Koumbaya/Kopesh/kopesh.bmp

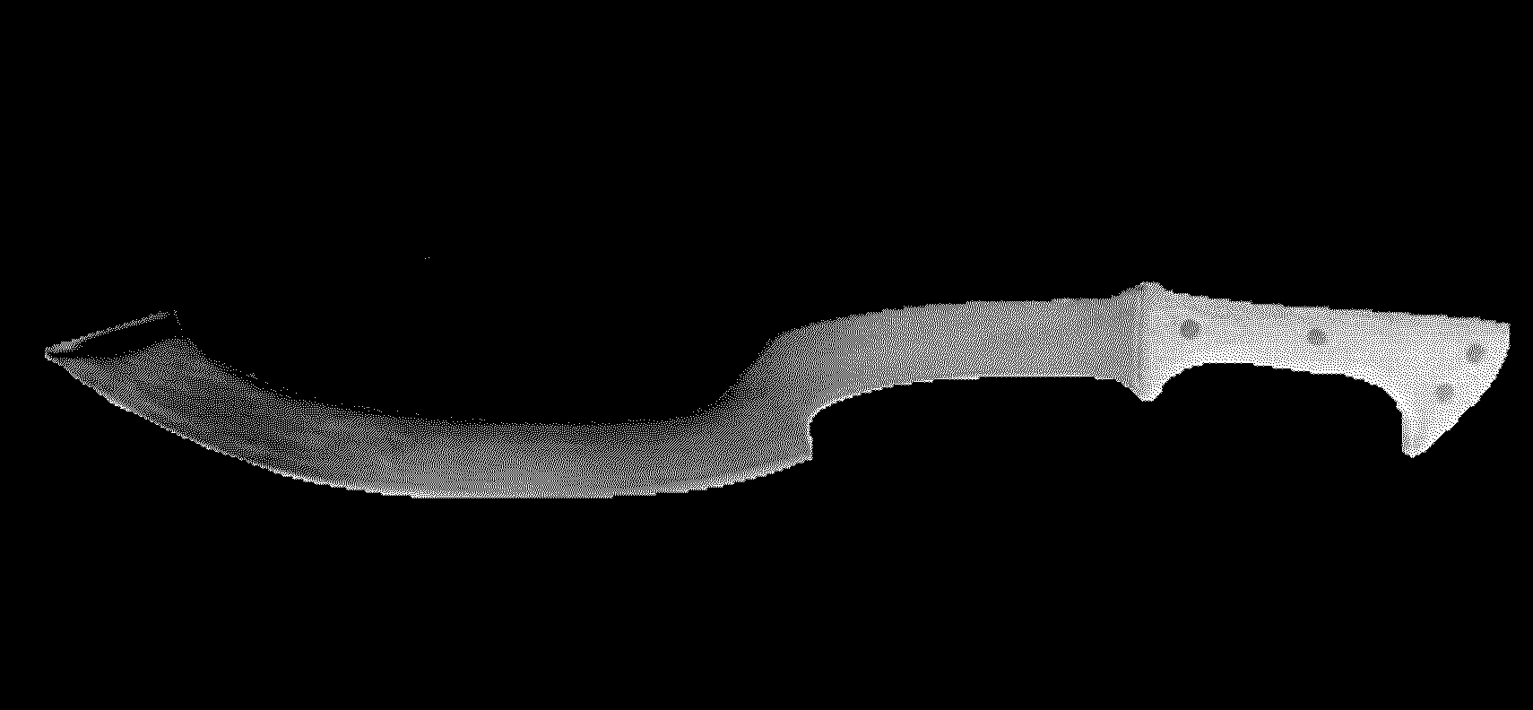
kopesh.bmp
