Koumbaya/Kopesh/kopesh.jpg

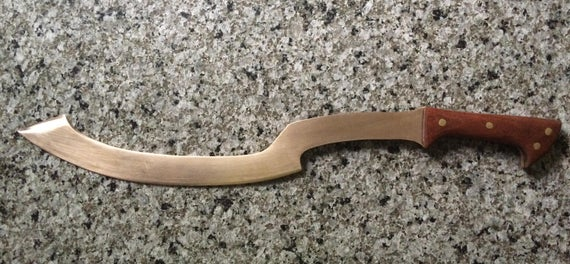
kopesh.jpg
