Koumbaya/Kopesh/pictures/kopesh2.PNG

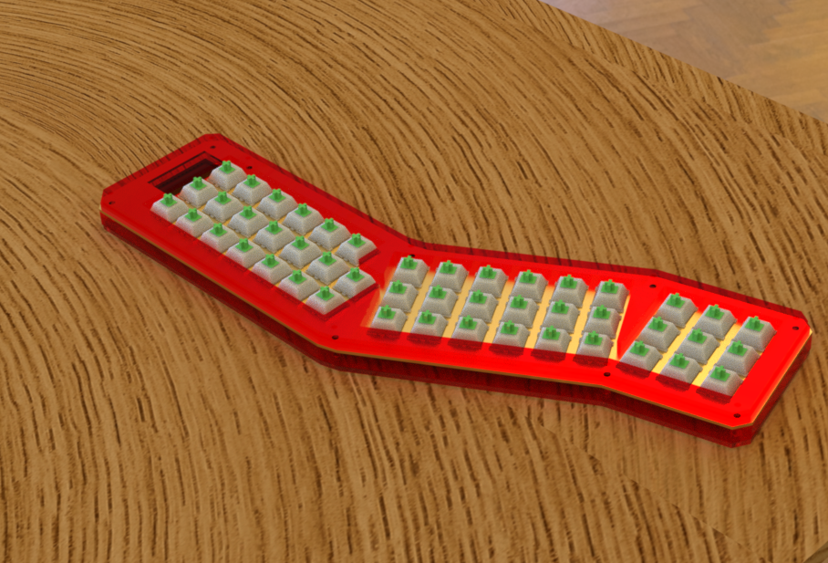
pictures/kopesh2.PNG
