Koumbaya/Kopesh/pictures/kopesh.png

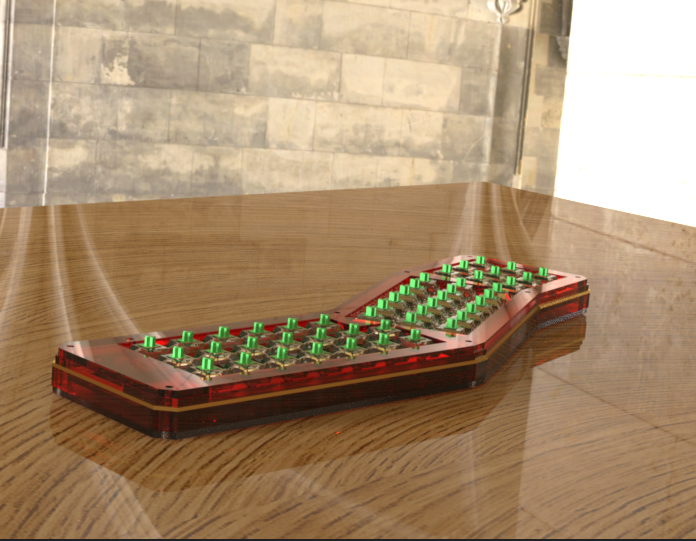
pictures/kopesh.png
