Koumbaya/Kopesh/pictures/kopeshcaps.PNG

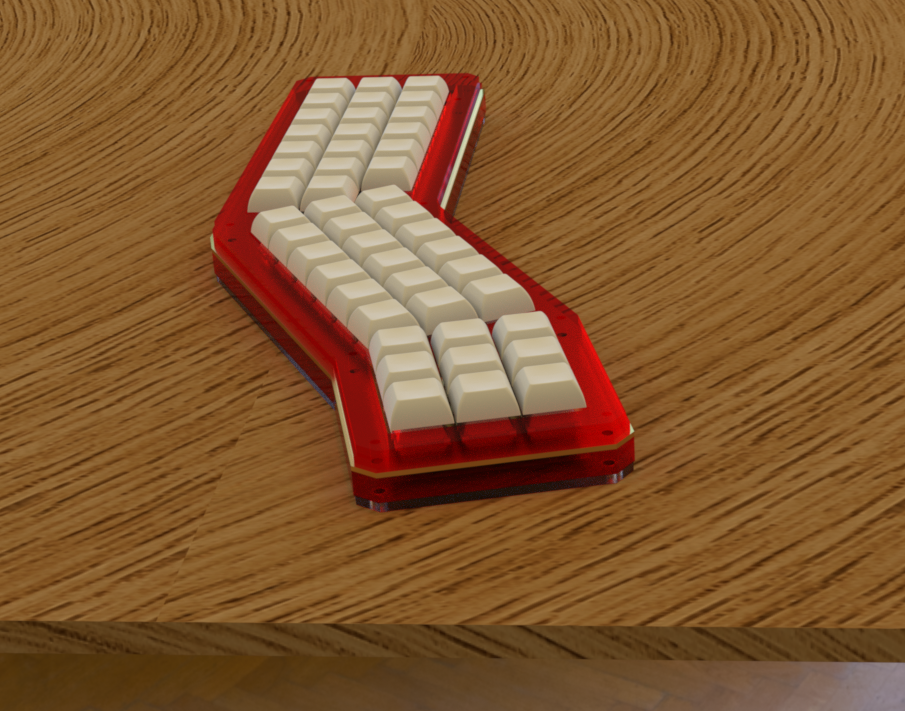
pictures/kopeshcaps.PNG
