Koumbaya/Kopesh/3DPrint/Assemblage_verif_clearance.SLDASM

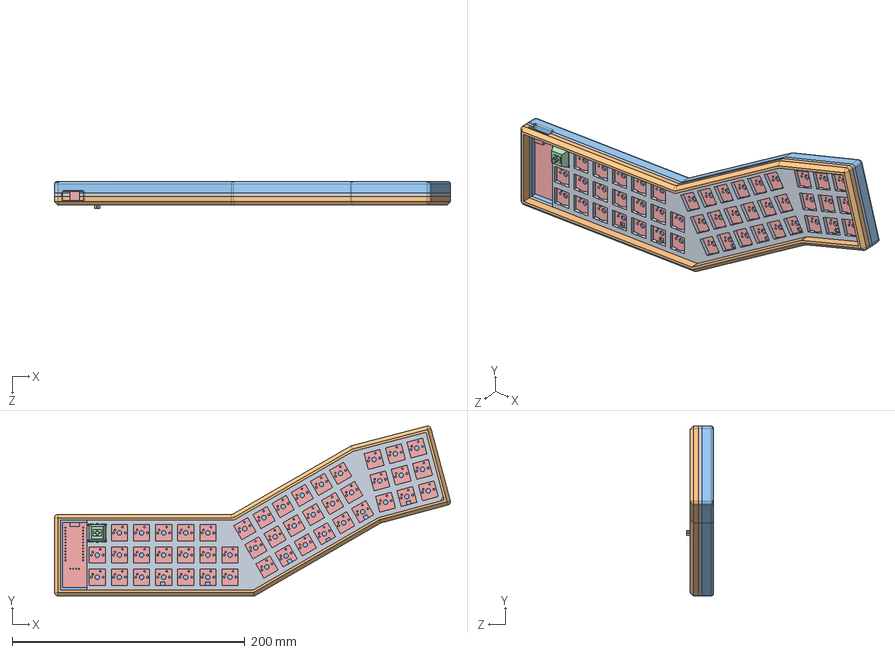
[picture p14: CAD file, 2020-05-24]
3DPrint/Assemblage_verif_clearance.SLDASM
340.1 x 146.0 x 23.2 mm
switchplate_plate_mount
top_plate_mount
basic_plate_mount
cherry mx
pcb
