Koumbaya/Kopesh/case/Assemblage1.SLDASM

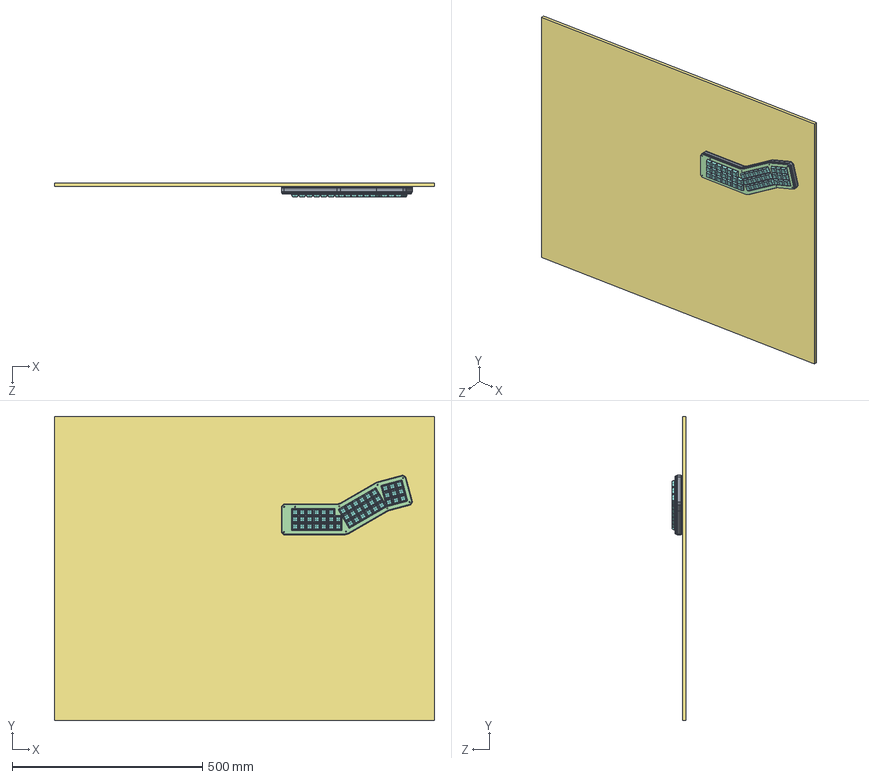
[picture p15: CAD file, 2020-05-05]
case/Assemblage1.SLDASM
1000.0 x 800.0 x 38.1 mm
switchplate
bottom
top1
top2
cherry mx x 47
pcb
table
DSA_Keycap_CherryMX.step x 47
middle3mm x 3
