Koumbaya/Kopesh/case/AssemblagePCB.SLDASM

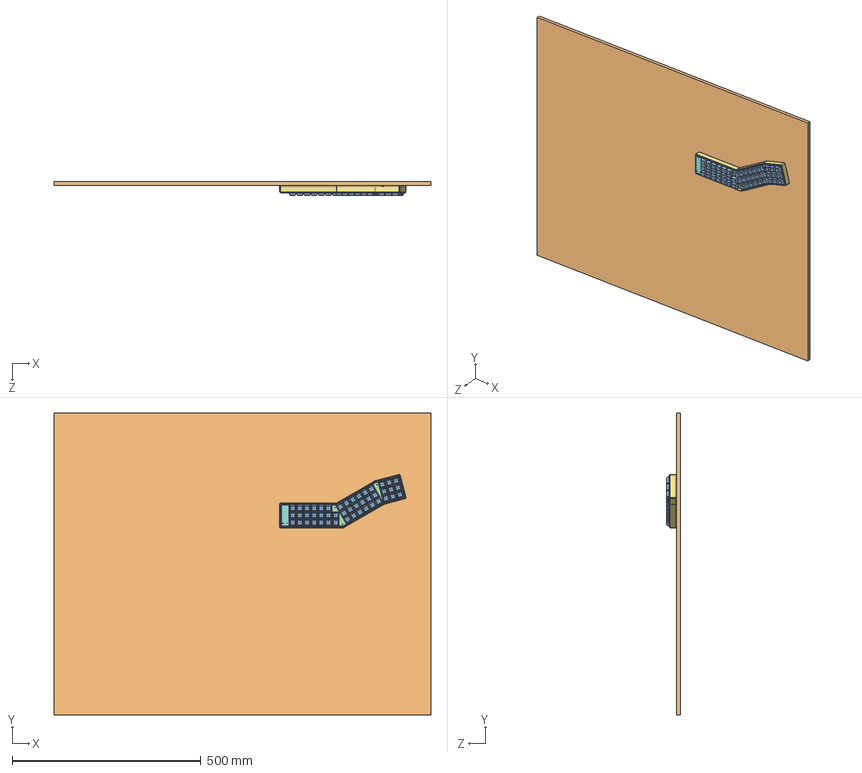
[picture p16: CAD file, 2020-04-27]
case/AssemblagePCB.SLDASM
1000.0 x 800.0 x 36.8 mm
cherry mx x 47
table
DSA_Keycap_CherryMX.step x 47
switchplateFR4
pcbFR4
bottomplate
basic_case
oled cover
