Koumbaya/Kopesh/3DPrint/top_plate_mount.SLDPRT

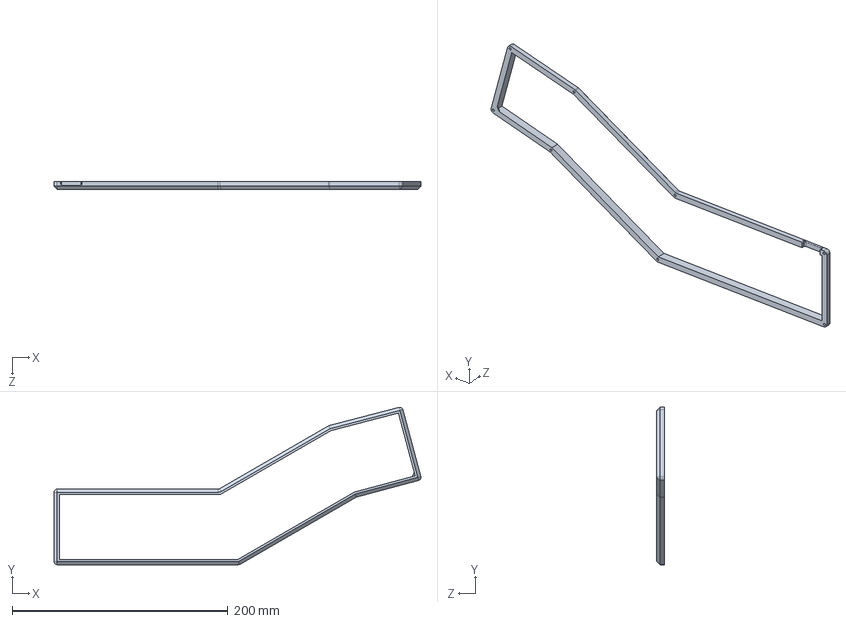
[picture p17: CAD file, 2020-05-24]
3DPrint/top_plate_mount.SLDPRT
340.1 x 146.0 x 7.20 mm
