Koumbaya/Kopesh/case/cutouts/switchplate.DXF

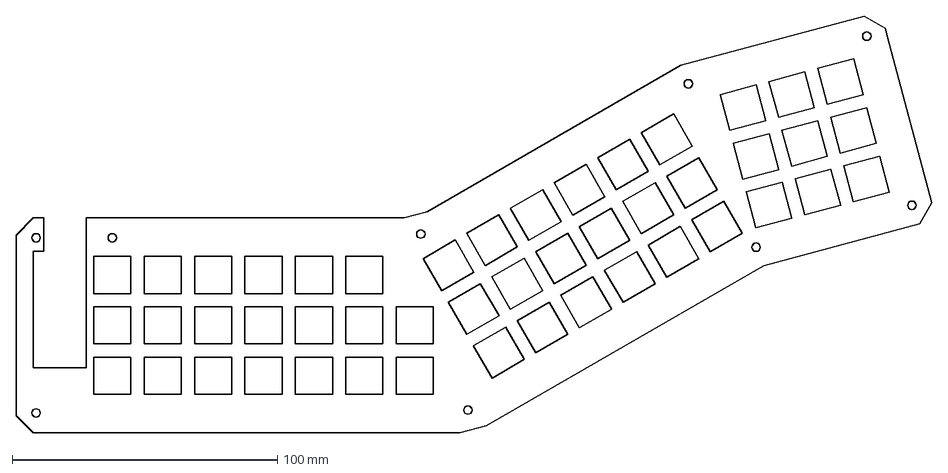
[picture p18: CAD file, 2020-10-13]
case/cutouts/switchplate.DXF
345.2 x 157.1 mm
