Koumbaya/Kopesh/case/switchplate.SLDPRT

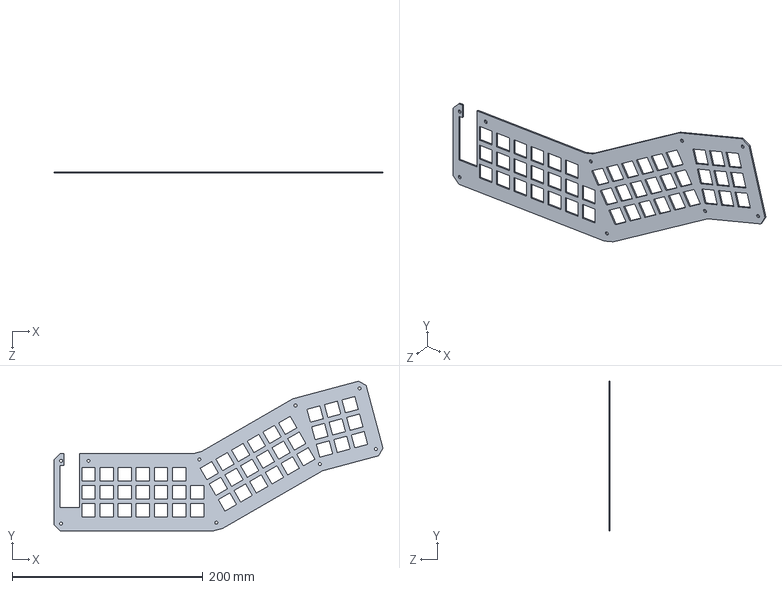
[picture p19: CAD file, 2020-10-13]
case/switchplate.SLDPRT
345.2 x 157.1 x 1.50 mm
