Koumbaya/Kopesh/FR4 Case/switchplate.DXF

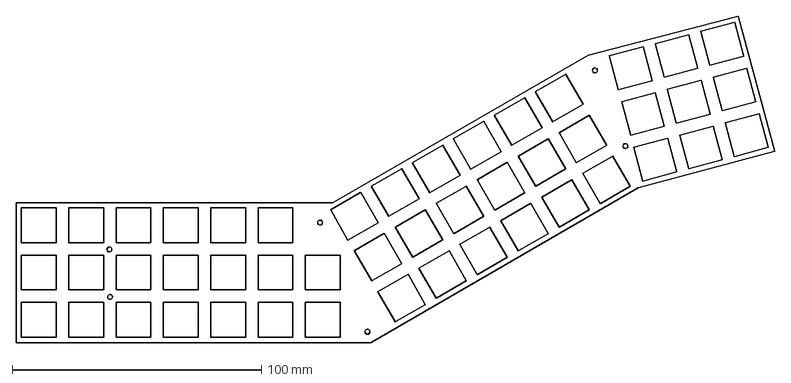
[picture p20: CAD file, 2020-05-05]
FR4 Case/switchplate.DXF
304.4 x 131.1 mm
