Koumbaya/Kopesh/gerbers/kopesh-drl_map.dxf

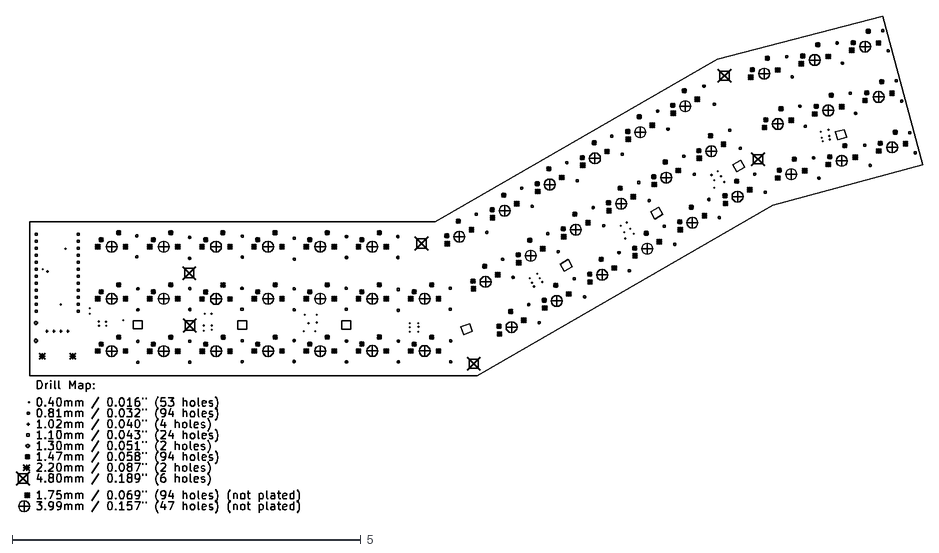
[picture p21: CAD file, 2020-10-13]
gerbers/kopesh-drl_map.dxf
13.0 x 7.13
