Koumbaya/Kopesh/kopesh.step

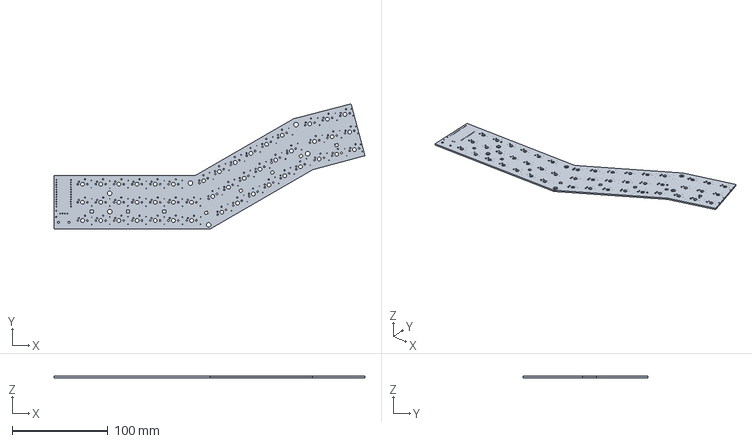
[picture p22: CAD file, 2020-04-27]
kopesh.step
325.2 x 131.1 x 1.60 mm
