Koumbaya/Kopesh/case/cutouts/top1.DXF

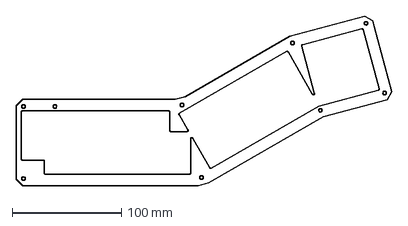
[picture p23: CAD file, 2020-10-13]
case/cutouts/top1.DXF
343.1 x 155.0 mm
