Koumbaya/Kopesh/case/gasket.SLDPRT

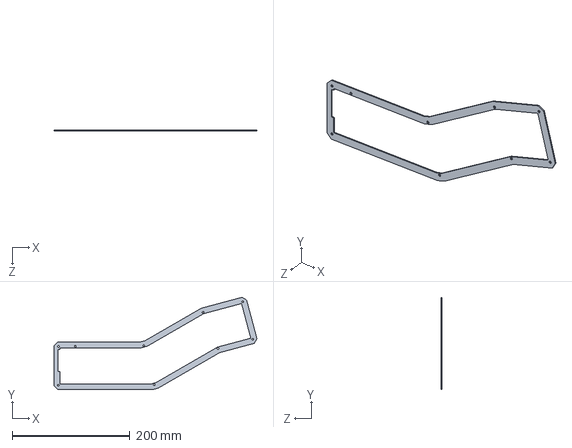
[picture p24: CAD file, 2020-10-13]
case/gasket.SLDPRT
345.2 x 157.1 x 1.50 mm
