Koumbaya/Kopesh/FR4 Case/switchplateFR4.SLDPRT

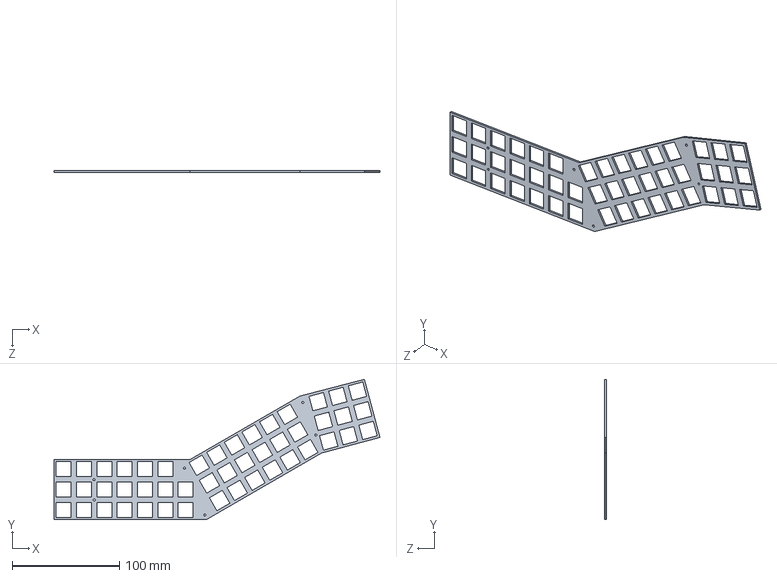
[picture p25: CAD file, 2020-05-05]
FR4 Case/switchplateFR4.SLDPRT
304.4 x 131.1 x 1.60 mm
