Koumbaya/Kopesh/gerbers/kopesh-Edge_Cuts.dxf

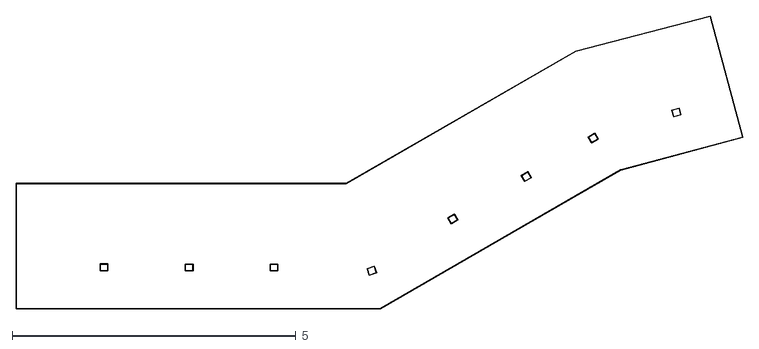
[picture p26: CAD file, 2020-06-10]
gerbers/kopesh-Edge_Cuts.dxf
12.8 x 5.16
