Koumbaya/Kopesh/3DPrint/switchplate_plate_mount.SLDPRT

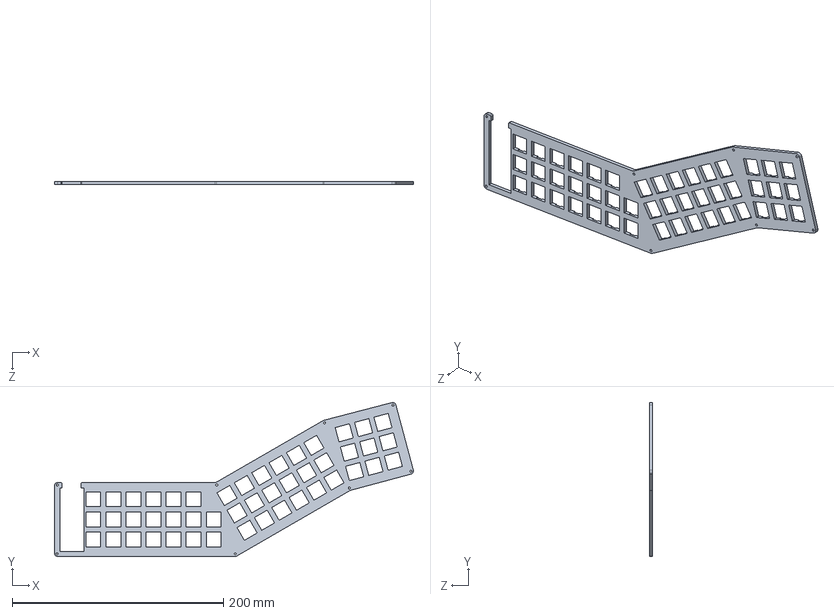
[picture p27: CAD file, 2020-05-24]
3DPrint/switchplate_plate_mount.SLDPRT
340.1 x 146.0 x 3.00 mm
