Koumbaya/Kopesh/case/cutouts/middle3.DXF

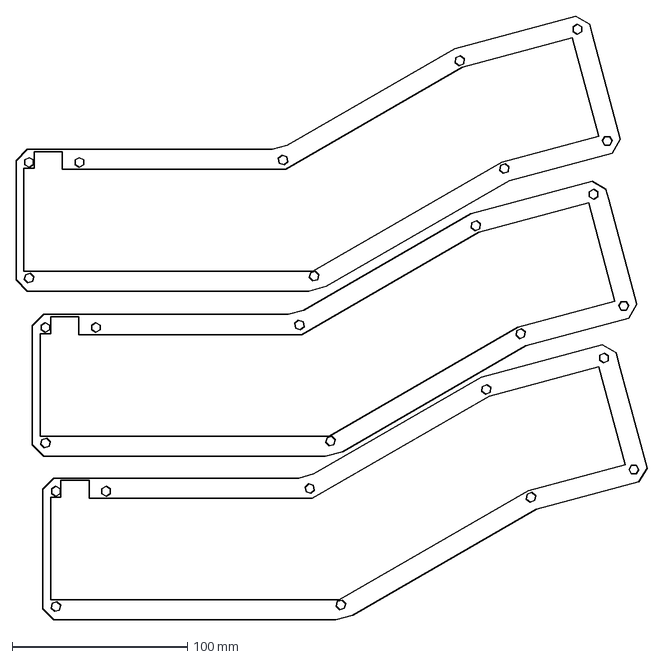
[picture p28: CAD file, 2020-05-01]
case/cutouts/middle3.DXF
360.4 x 344.8 mm
