Koumbaya/Kopesh/case/top1.SLDPRT

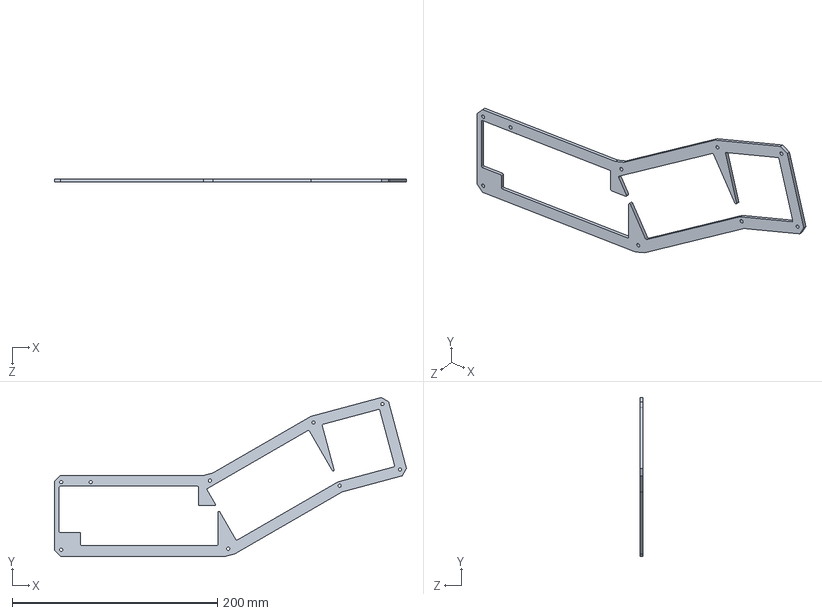
[picture p29: CAD file, 2020-10-13]
case/top1.SLDPRT
343.1 x 155.0 x 3.00 mm
