Koumbaya/Kopesh/FR4 Case/oled cover.SLDPRT

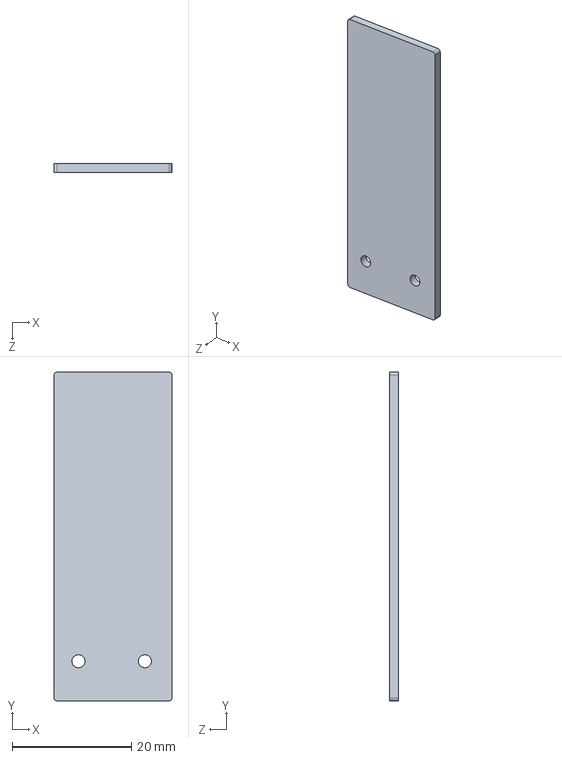
[picture p30: CAD file, 2020-04-27]
FR4 Case/oled cover.SLDPRT
19.8 x 55.2 x 1.50 mm
