Koumbaya/Kopesh/kopesh-Edge_Cuts.dxf

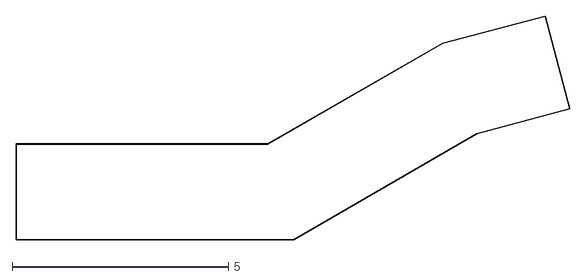
[picture p31: CAD file, 2020-04-19]
kopesh-Edge_Cuts.dxf
12.8 x 5.16
