Koumbaya/Kopesh/3DPrint/basic_plate_mount.SLDPRT

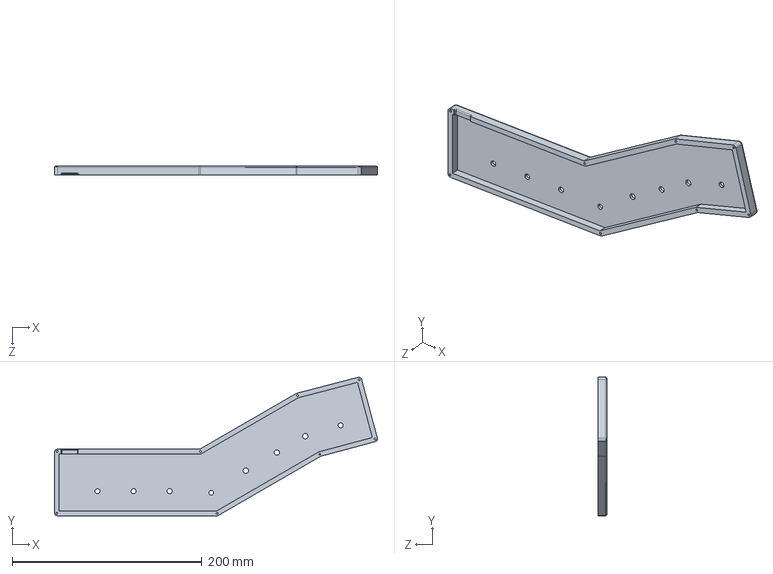
[picture p32: CAD file, 2020-05-24]
3DPrint/basic_plate_mount.SLDPRT
340.1 x 146.0 x 10.0 mm
