Koumbaya/Kopesh/case/cutouts/bottom.DXF

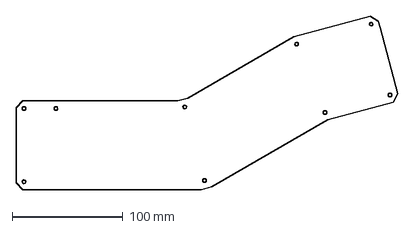
[picture p33: CAD file, 2020-04-25]
case/cutouts/bottom.DXF
344.1 x 156.0 mm
