Koumbaya/Kopesh/case/middle9mm3d.SLDPRT

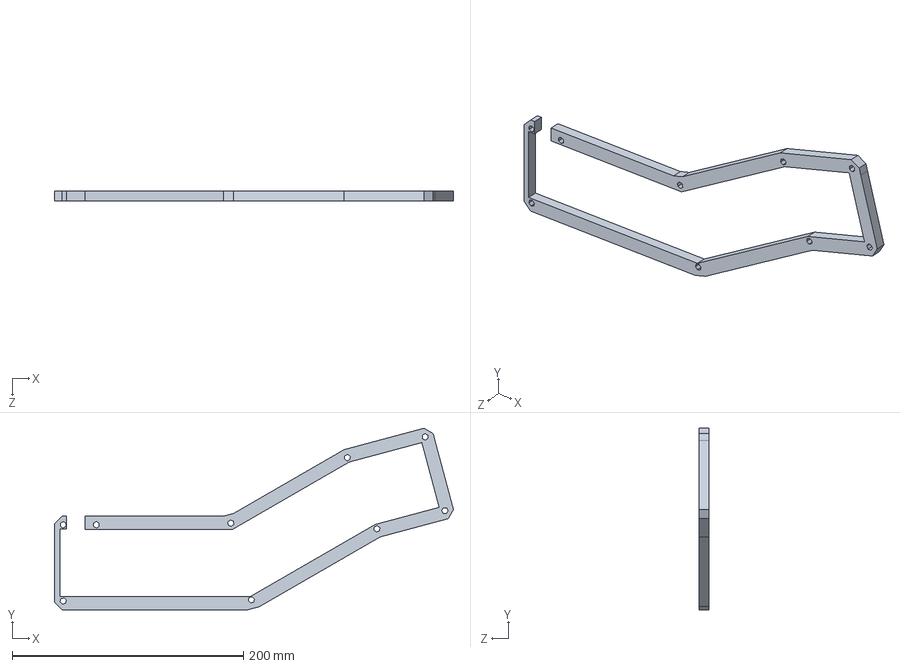
[picture p34: CAD file, 2020-06-10]
case/middle9mm3d.SLDPRT
345.2 x 157.0 x 8.50 mm
