Koumbaya/Kopesh/3DPrint/basic_case.SLDPRT

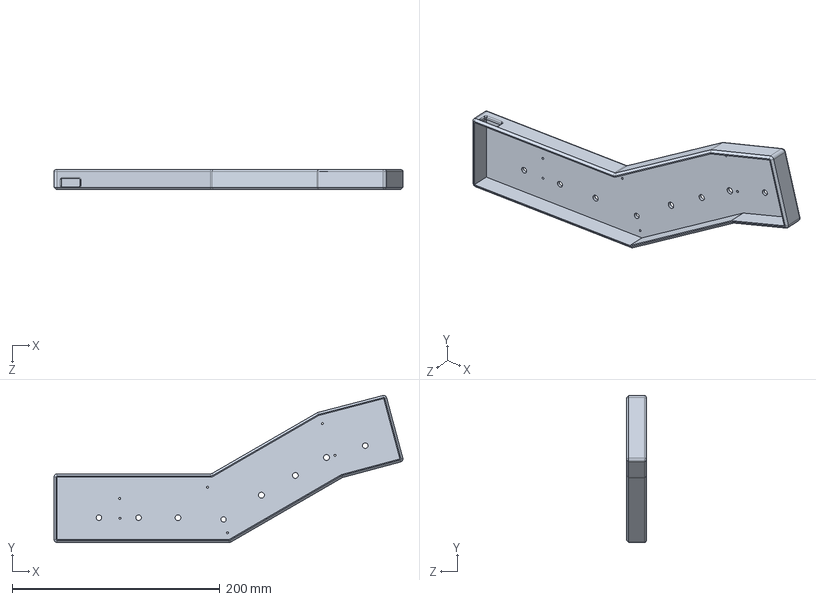
[picture p35: CAD file, 2020-05-22]
3DPrint/basic_case.SLDPRT
335.6 x 141.5 x 19.0 mm
