Koumbaya/Kopesh/case/cutouts/top2.DXF

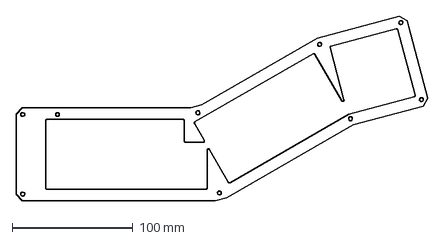
[picture p36: CAD file, 2020-04-25]
case/cutouts/top2.DXF
341.0 x 152.9 mm
