Koumbaya/Kopesh/case/pcb.SLDPRT

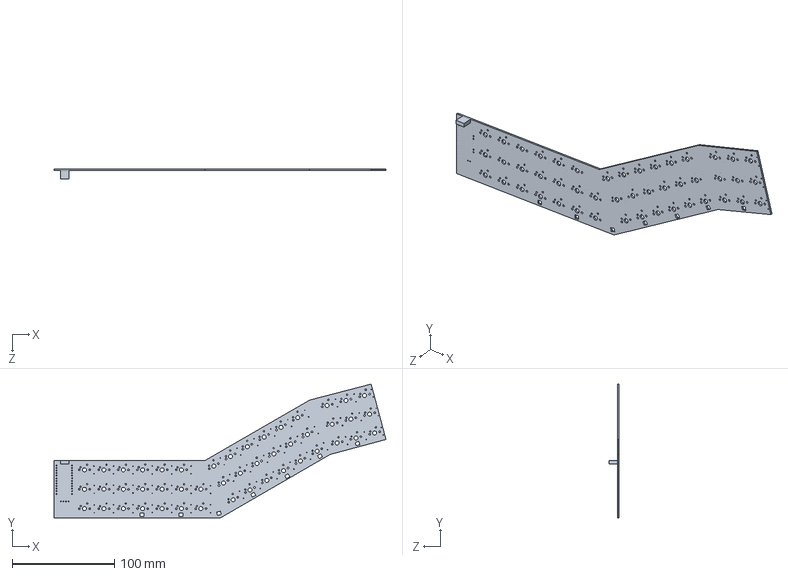
[picture p37: CAD file, 2020-05-22]
case/pcb.SLDPRT
325.2 x 131.1 x 10.2 mm
