Koumbaya/Kopesh/FR4 Case/bottomplate.SLDPRT

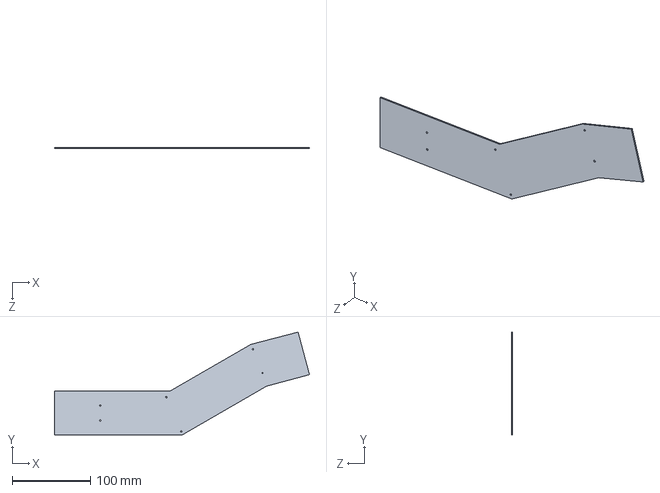
[picture p38: CAD file, 2020-04-27]
FR4 Case/bottomplate.SLDPRT
325.2 x 131.1 x 1.60 mm
