Koumbaya/Kopesh/logosp.DXF

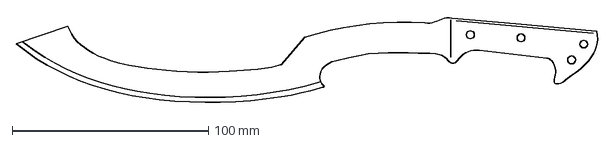
[picture p39: CAD file, 2020-03-30]
logosp.DXF
296.1 x 43.1 mm
