Koumbaya/Kopesh/3DPrint/bottomplate.STL

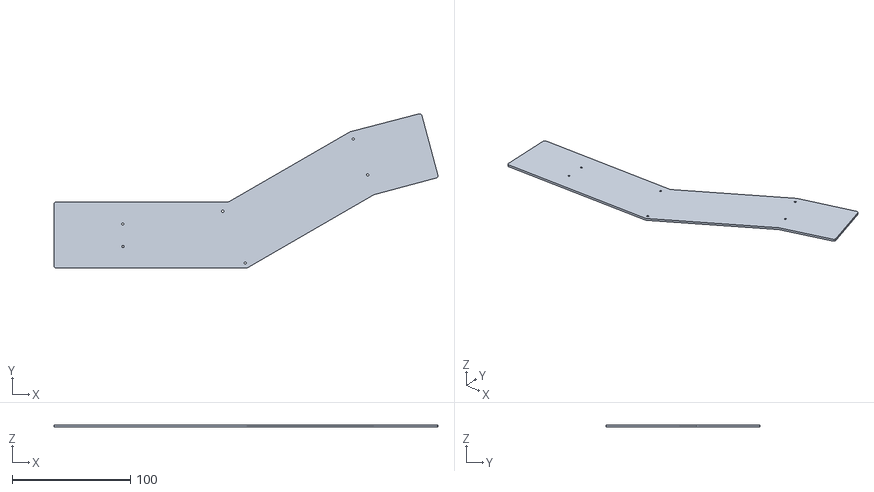
[picture p40: CAD file, 2020-04-26]
3DPrint/bottomplate.STL
324.7 x 130.6 x 2.00
