Koumbaya/Kopesh/case/cutouts/middle.DXF

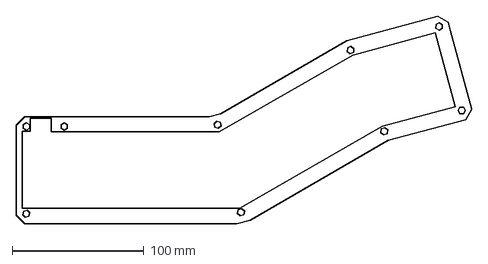
[picture p41: CAD file, 2020-04-25]
case/cutouts/middle.DXF
345.2 x 157.0 mm
