Koumbaya/Kopesh/logo_small.DXF

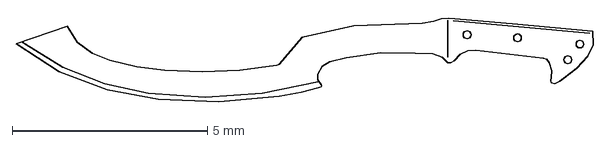
[picture p42: CAD file, 2020-03-30]
logo_small.DXF
14.8 x 2.14 mm
