Koumbaya/Kopesh/3DPrint/switchplate_split_p1.STL

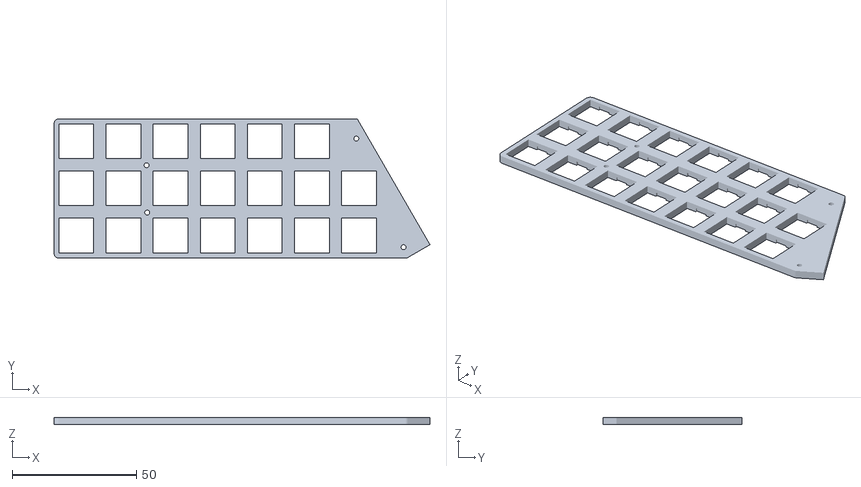
[picture p43: CAD file, 2020-04-26]
3DPrint/switchplate_split_p1.STL
151.6 x 56.2 x 3.00
