Koumbaya/Kopesh/case/middle3dPrint.SLDPRT

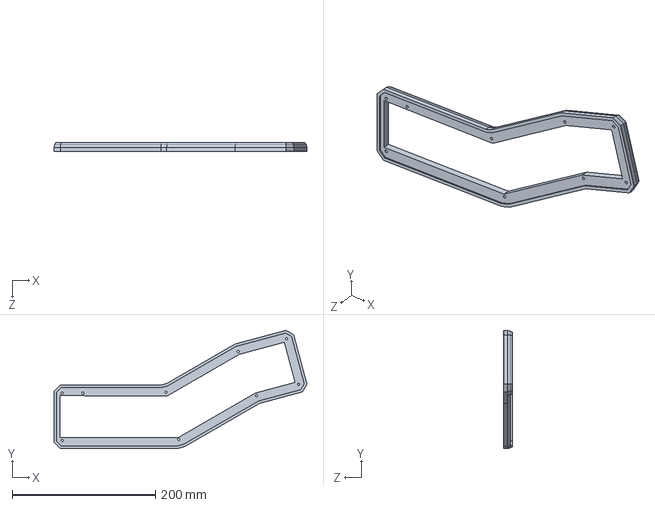
[picture p44: CAD file, 2020-05-05]
case/middle3dPrint.SLDPRT
353.5 x 165.3 x 12.5 mm
