Koumbaya/Kopesh/outline.DXF

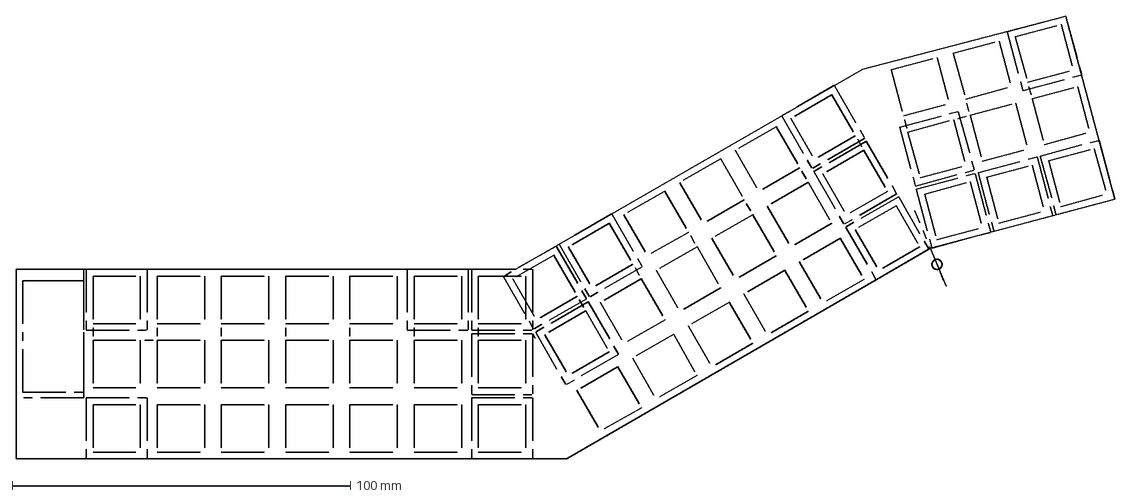
[picture p45: CAD file, 2020-03-22]
outline.DXF
325.0 x 130.9 mm
