Koumbaya/Kopesh/3DPrint/switchplate.SLDPRT

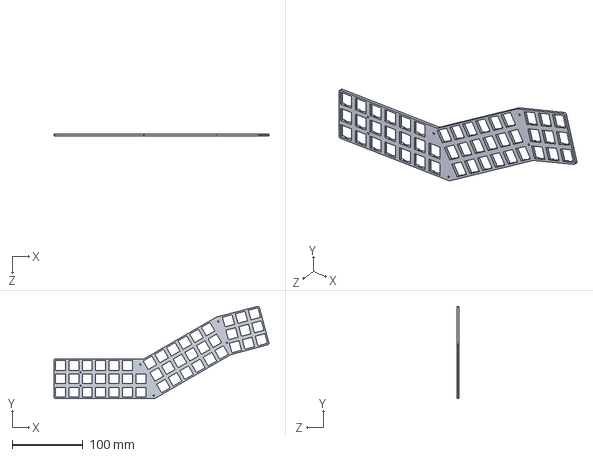
[picture p46: CAD file, 2020-04-26]
3DPrint/switchplate.SLDPRT
304.0 x 130.6 x 3.00 mm
