Koumbaya/Kopesh/case/middle3mm.SLDPRT

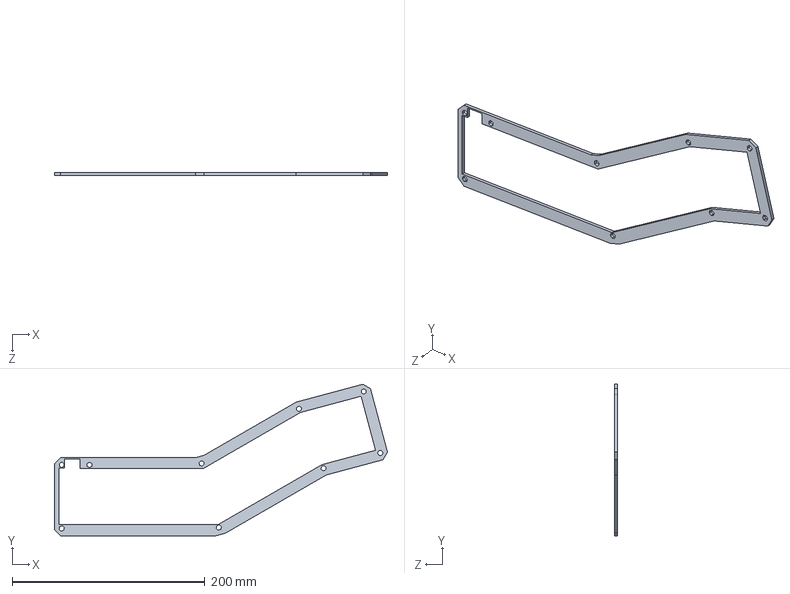
[picture p47: CAD file, 2020-05-05]
case/middle3mm.SLDPRT
345.2 x 157.0 x 3.00 mm
