Koumbaya/Kopesh/3DPrint/switchplate_split_p2.STL

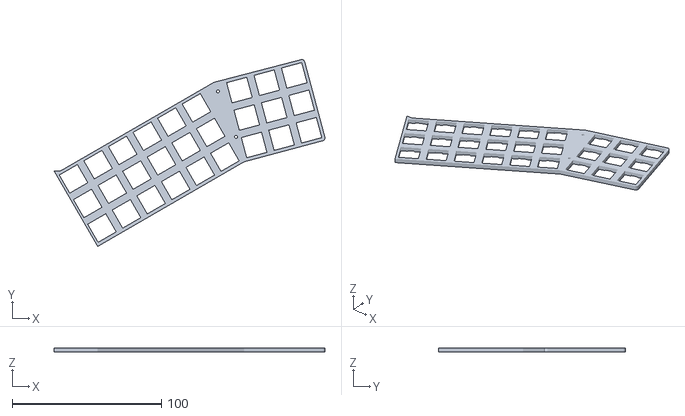
[picture p48: CAD file, 2020-04-26]
3DPrint/switchplate_split_p2.STL
181.4 x 125.1 x 3.00
