Koumbaya/Kopesh/case/top3d.SLDPRT

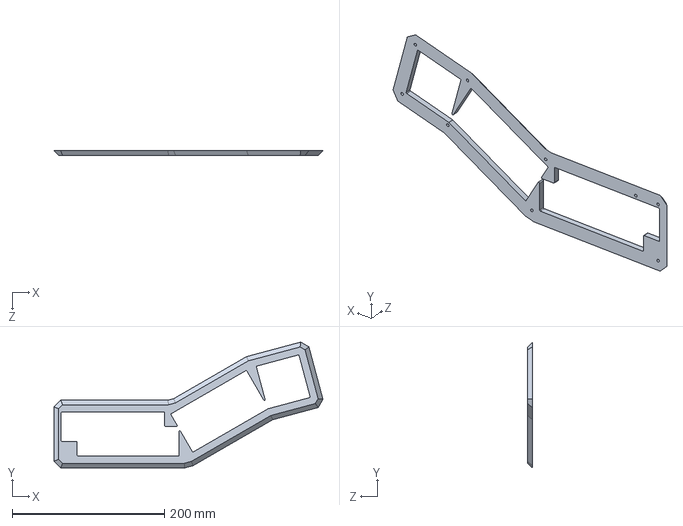
[picture p49: CAD file, 2020-05-05]
case/top3d.SLDPRT
353.5 x 165.3 x 6.50 mm
