Koumbaya/Kopesh/case/bottom.SLDPRT

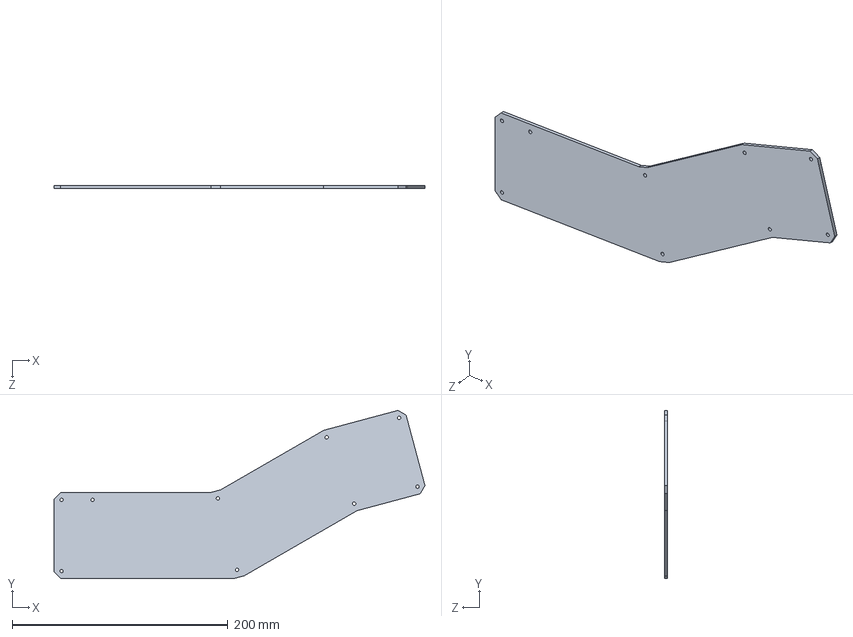
[picture p50: CAD file, 2020-05-05]
case/bottom.SLDPRT
344.1 x 156.0 x 3.00 mm
