Koumbaya/Kopesh/case/middle3dPrint2.SLDPRT

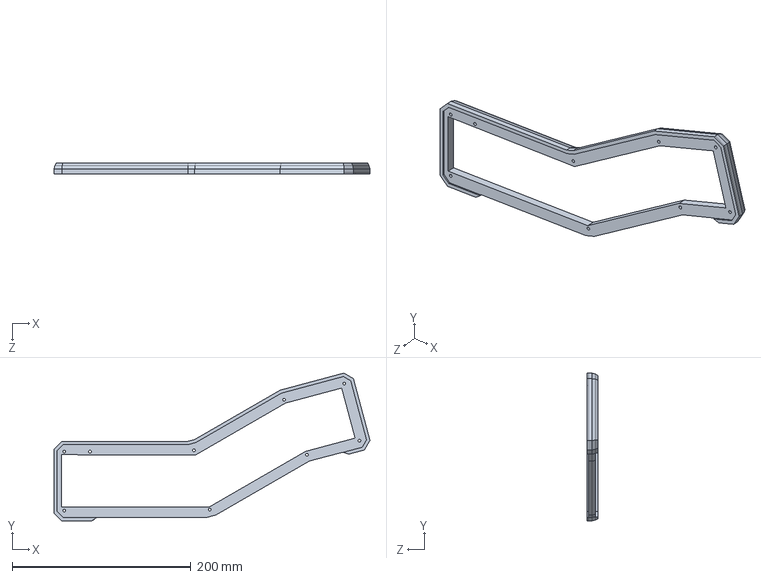
[picture p51: CAD file, 2020-05-05]
case/middle3dPrint2.SLDPRT
353.5 x 165.3 x 12.5 mm
