Koumbaya/Kopesh/case/table.SLDPRT

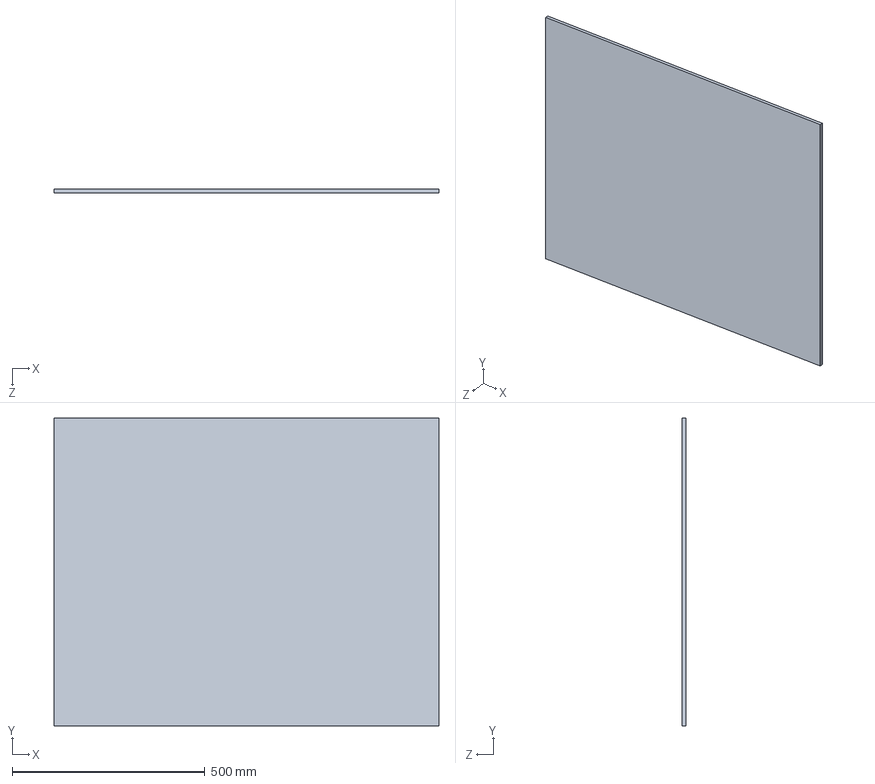
[picture p52: CAD file, 2020-04-26]
case/table.SLDPRT
1000.0 x 800.0 x 10.0 mm
