Koumbaya/Kopesh/case/MX Series-Cherry Key.SLDPRT

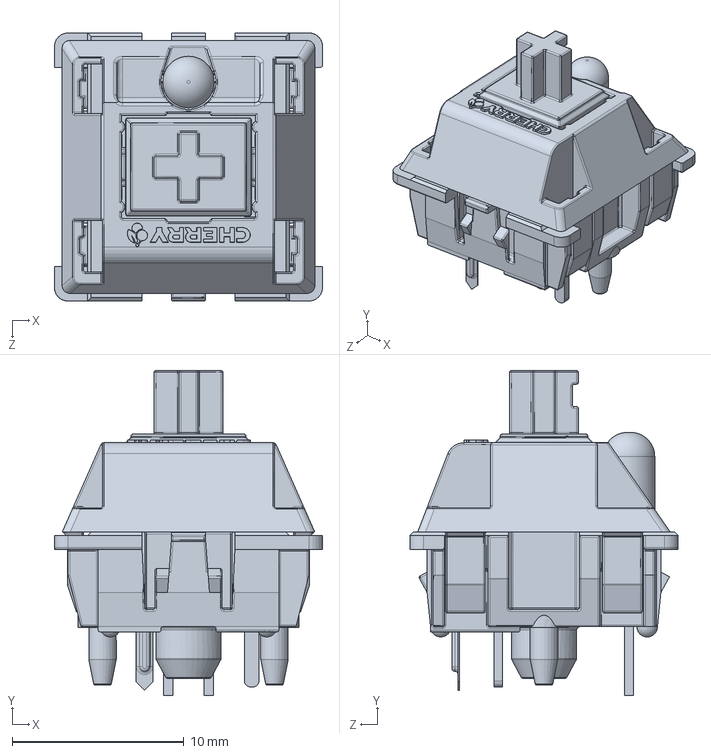
[picture p53: CAD file, 2020-04-25]
case/MX Series-Cherry Key.SLDPRT
15.6 x 18.9 x 15.6 mm
