Koumbaya/Kopesh/case/DSA_Keycap_CherryMX.step

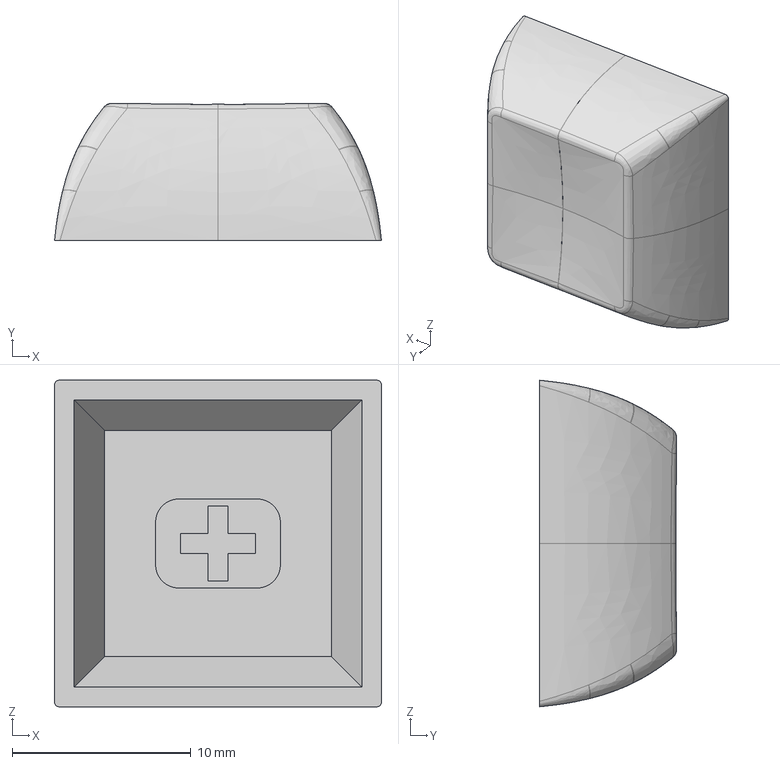
[picture p54: CAD file, 2020-04-25]
case/DSA_Keycap_CherryMX.step
18.3 x 7.69 x 18.3 mm
