Koumbaya/Kopesh/case/cherry mx.SLDPRT

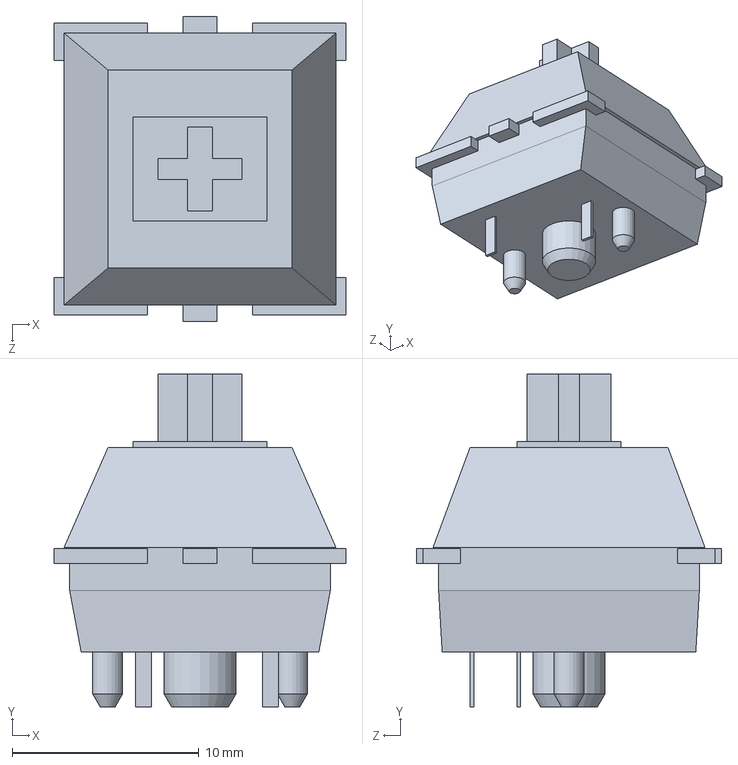
[picture p55: CAD file, 2020-04-18]
case/cherry mx.SLDPRT
15.6 x 17.9 x 16.3 mm
