Koumbaya/Kopesh/case/middle.SLDPRT

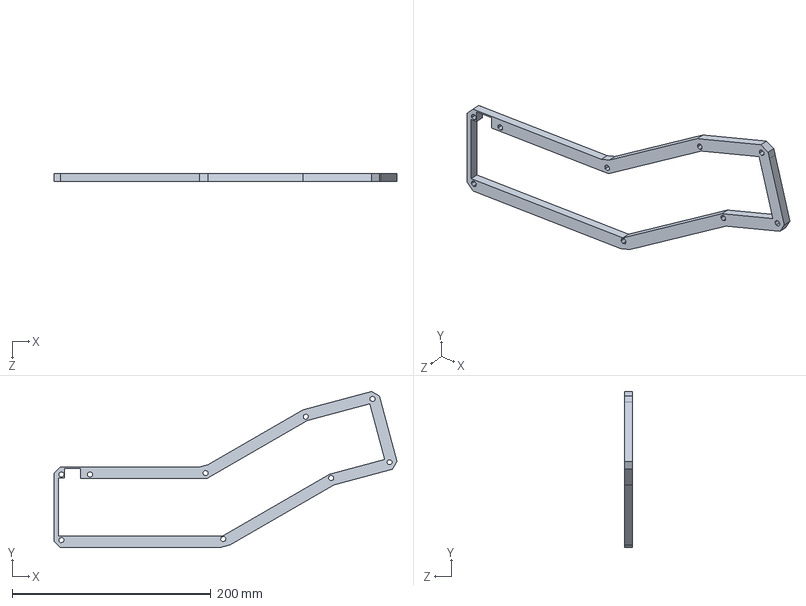
[picture p56: CAD file, 2020-04-18]
case/middle.SLDPRT
345.2 x 157.0 x 8.00 mm
