Koumbaya/Kopesh/(list of files, cad)

Other CAD files:
case/Assemblagemiddle3d.SLDASM
logo.SLDPRT
FR4 Case/pcbFR4.SLDPRT
case/top2.SLDPRT
case/kopesh.step
3DPrint/basic_case.STL
3DPrint/basic_plate_mount.STL
3DPrint/switchplate.STL
3DPrint/switchplate_plate_mount.STL
3DPrint/top_plate_mount.STL
FR4 Case/bottomplate.DXF
FR4 Case/oled cover.DXF
case/gasket.STL
case/middle9mm3d.STL
kopesh-B_Mask.dxf
logo.DXF
