Koumbaya/Kopesh/(commit log)

2020-03-22 add kicad files
    [kopesh.kicad_pcb, kopesh.sch]
2020-03-22 add plates files
    [Assemblage1.SLDASM, bottom.SLDPRT, cherry mx.SLDPRT, middle.SLDPRT, switchplate.SLDPRT, top1.SLDPRT, top2.SLDPRT]
2020-03-22 switch onto pcb
    [kopesh.sch, outline.DXF]
2020-03-23 début route
    [Assemblage1.SLDASM, kopesh.kicad_pcb, kopesh.sch, kopesh.step, pcb.SLDPRT]
2020-03-23 moar root
    [kopesh.kicad_pcb]
2020-03-24 almost done
    [kopesh.kicad_pcb, kopesh.sch]
2020-03-24 derniere version
    [kopesh.kicad_pcb, kopesh.step]
2020-03-24 ajoute d'une mini modif pour comit
    [kopesh.kicad_pcb]
2020-04-18 inverted SDA SCK which were wrong
    [Assemblage1.SLDASM, bottom.SLDPRT, cherry mx.SLDPRT, kopesh.kicad_pcb, kopesh.sch, middle.SLDPRT, pcb.SLDPRT, switchplate.SLDPRT]
2020-04-19 replaced TH diodes with TH+SMD, added FR4 plates
    [Pièce1.SLDPRT, bottomplate.DXF, kopesh-B_Fab.dxf, kopesh-B_Mask.dxf, kopesh-Edge_Cuts.dxf, kopesh.kicad_pcb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]
2020-04-19 add reset btn
    [kopesh.kicad_pcb, kopesh.sch]
2020-04-19 update to V2
    [fr4.kicad_pcb, fr4.sch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]
2020-04-25 Big update of everything exept the PCB
    [Assemblage1.SLDASM, AssemblagePCB.SLDASM, DSA_Keycap_CherryMX.step, MX Series-Cherry Key.SLDPRT, Pièce1.SLDPRT, bottom.DXF, bottomplate.SLDPRT, fr4.kicad_pcb]
2020-04-26 add 3d printed plate
    [switchplate.SLDPRT, switchplate.STL, switchplate_split_p1.STL, switchplate_split_p2.STL, table.SLDPRT]
2020-04-26 added case
    [AssemblagePCB.SLDASM, basic_case.SLDPRT, basic_case.STL, bottomplate.STL]
2020-04-27 added holes in the PCB for oled acrylic cover
    [AssemblagePCB.SLDASM, bottomplate.SLDPRT, kopesh.kicad_pcb, kopesh.step, oled cover.DXF, oled cover.SLDPRT, pcbFR4.SLDPRT, switchplateFR4.SLDPRT]
2020-04-27 added gerbers for 2.1 (oled cover holes)
    [kopesh-B_Cu.gbr, kopesh-B_Mask.gbr, kopesh-B_SilkS.gbr, kopesh-Edge_Cuts.gbr, kopesh-F_Cu.gbr, kopesh-F_Mask.gbr, kopesh-F_SilkS.gbr, kopesh.drl]
2020-04-27 added sandwish 3D Printed case for both V1 and V2 in platemount
    [Assemblage_verif_clearance.SLDASM, basic_plate_mount.SLDPRT, basic_plate_mount.STL, switchplate_plate_mount.SLDPRT, switchplate_plate_mount.STL, top_plate_mount.SLDPRT, top_plate_mount.STL]
2020-05-01 added 3 part plate mount case
    [Assemblage_verif_clearance.SLDASM, basic_plate_mount.SLDPRT, middle3.DXF, switchplate_plate_mount.SLDPRT, top-bottom.DXF, top_plate_mount.SLDPRT]
2020-05-05 fixed FR4 plates (all files should be good now)
    [Assemblage1.SLDASM, Assemblagemiddle3d.SLDASM, bottom.SLDPRT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]
2020-05-13 add real pics of acrylic case
2020-05-17 added hole for usb on 3D printed cases (totally forgot !)
    [Assemblage_verif_clearance.SLDASM, basic_case.SLDPRT, basic_plate_mount.SLDPRT, switchplate_plate_mount.SLDPRT, top_plate_mount.SLDPRT]
2020-05-17 forogt hole for USB on 3D printed cases (stl update)
    [basic_case.STL, basic_plate_mount.STL, switchplate_plate_mount.STL, top_plate_mount.STL]
2020-05-22 little update on 3D printed case with better clearance for USB port & hole for the LEDs
    [Assemblage_verif_clearance.SLDASM, basic_plate_mount.SLDPRT, basic_plate_mount.STL, pcb.SLDPRT, top_plate_mount.SLDPRT, top_plate_mount.STL]
2020-05-22 update clearance usb port for 3 print case + holes for LEDs
    [basic_case.SLDPRT, basic_case.STL]
2020-05-23 addd notes for the special case of the acrylic case
2020-05-24 update top for 3 parts case
    better screw size, added a mm on top
    [Assemblage_verif_clearance.SLDASM, basic_plate_mount.SLDPRT, switchplate_plate_mount.SLDPRT, top_plate_mount.SLDPRT, top_plate_mount.STL]
2020-05-24 add pic 3d case
2020-06-10 add LEDs to the firmware. still work to do
    [kopesh-Edge_Cuts.dxf, middle9mm3d.SLDPRT, middle9mm3d.STL]
2020-10-13 small changes on cutouts
    [gasket.SLDPRT, gasket.STL, kopesh-drl_map.dxf, switchplate.DXF, switchplate.SLDPRT, top-bottom.DXF, top1.DXF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]
2020-10-13 bigger usb cuttout on switchplate
    [switchplate.DXF, switchplate.SLDPRT]
